nick-dumas/line_follow/images/wiring-detail.jpg

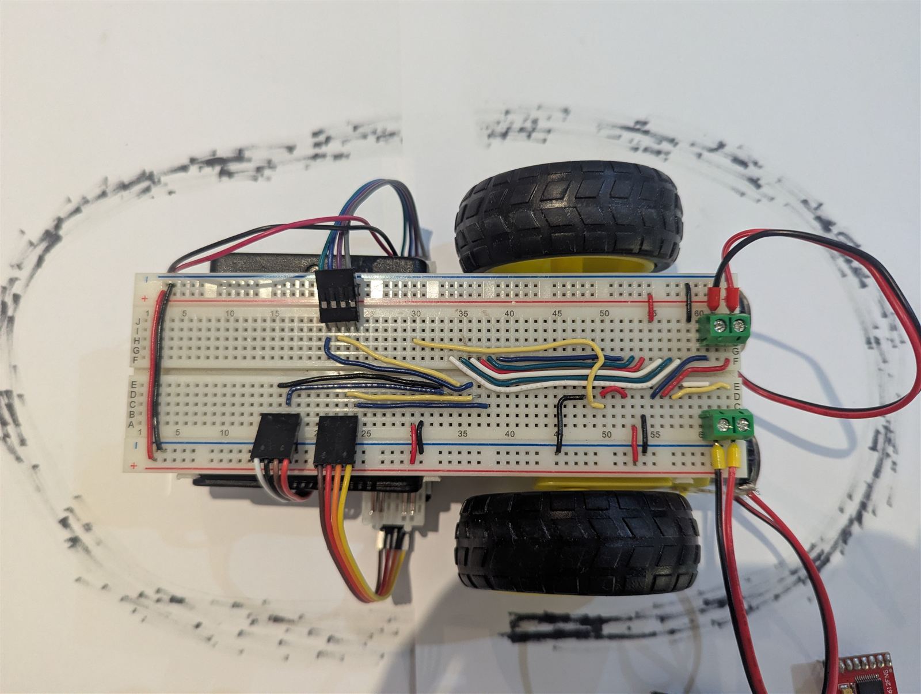
images/wiring-detail.jpg
