nick-dumas/line_follow/(commit log)

2026-06-15 initial arduino
2026-06-16 With new wiring
2026-06-17 Change pins to avoid crash
    [main.cpp]
2026-06-18 Fix movement
    Still needs better caster wheel or omniwheel to work
    [main.cpp]
2026-06-24 Add HC-SR04 ultrasonic distance sensor with pre-start telemetry (#1)
    * Initial plan
    * Add HC-SR04 ultrasonic sensor support (TRIG=GPIO2, ECHO=GPIO4)
    ---------
2026-06-24 BOM first draft
2026-06-25 Update readme
    Updated the Bill of Materials and added a section on speed for improved clarity.
2026-06-28 Add warning for ESP32 boards regarding USB backfeed
    Added a warning about the ESP32 boards lacking a protective diode.
